WurthElektronik/KiCad-Library/README.md

`KiCad Libraries for Würth Elektronik Products`
=========
## Introduction
Welcome to Würth Elektronik KiCad Library repository. <br>
The libraries are created and maintained by Würth Elektronik EDA Team, for any questions and suggestions please feel free to contact EDA team by email: <libraries@we-online.com>

## Library Component Coverage
* Electromechanical Components <br>
_Assembly, Connectors, REDCUBE Terminals, Switches_

* Optoelectronic Components <br>
_7 Segments Display, IC LEDs, Infrared, Laser, LEDs, Optical Sensors, Optocoupler, Ultraviolet_

* Passive Components <br>
_Capacitors, Crystals & Oscillators, EMC & RFI Components, Inductors, Resistors, Signal & Communications, Transformers_

* Power Modules (MagI3C Series) <br>
_Digital Isolator, Isolated Converter, LED Driver, Step Down Converter_

## More Library Repositories Provided By Würth Elektronik
**PCB Library**: [Cadence](https://github.com/WurthElektronik/Cadence-Library), [Eagle](https://github.com/WurthElektronik/Eagle-Library), [Altium](https://github.com/WurthElektronik/Altium-Library)    <br>
**Simulation Library**: [ADS](https://github.com/WurthElektronik/ADS-Library), [Ansys](https://github.com/WurthElektronik/Ansys-Library), [IBIS](https://github.com/WurthElektronik/IBIS-Library), [LTspice](https://github.com/WurthElektronik/LTspice-Library), [Pspice](https://github.com/WurthElektronik/Pspice-Library), [Qspice](https://github.com/WurthElektronik/Qspice-Library)
