WurthElektronik/KiCad-Library/how_to_contact_us.txt

Please let us know if you have any advice or questions:
libraries@we-online.com
