WurthElektronik/KiCad-Library/(commit log)

2024-10-22 upload and update library
    new upload:
    MLCC capacitor: WCAP-CSGP
    Ferrite: WE-CBF, WE-CBF-HF, WE-MPSB, WE-TMSB
    CM chokes: WE-CMB, WE-CNSW
    update:
    Power Inductor: WE-HCI, WE-LQS, WE-LQSH, WE-MAPI, WE-PD, WE-PMCI, WE-PMI, WE-TI
2025-01-07 upload library
    WCAP-AIG8
    WCAP-AIE8
    WCAP-AIG5
    WCAP-AI3H
    update WP-RATR footprint
2025-01-16 upload library
    Power Modules
2025-04-16 update library
    update all capacitor symbols and update all footprint value to invisible
2025-09-12 upload library
    2025.09.12:
    WE-GDT
    WE-CMBH
    WE-CMBHV
    WE-HCFAT
    WE-STST
    WE-UOST
    WE-SMGS
    WE-LLCR
    WE-BMS
    WE-UKW
    WE-WAFB
    WE-PSPA
    WE-PoEH
    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
2025-10-31 update library
    update WE-TVSP footprint with more visible anode remark
2025-12-04 update library
    Add an excel to display all released series of WE product
    [Git_WE_KiCad_Released_Series_List.xlsx]
2025-12-26 upload library
    Merry Christmas and Happy New Year!
    2025.12.26:
    WL-OCTR
    WE-IBTI
    WE-FLYTI
    WE-OLEFD
    WE-OLLT
    WE-OLEE
    WE-OLRM
    WE-PPTM
    WE-OLPI
    [Git_WE_KiCad_Released_Series_List.xlsx]
2026-01-26 upload and update library
    2026.01.26
    WR-NPC2
    WE-VD
    [Git_WE_KiCad_Released_Series_List.xlsx]
2026-01-29 update library
    2026.01.29:
    WE-GF
    WE-PDA
    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
    [Git_WE_KiCad_Released_Series_List.xlsx]
2026-03-06 upload and update library
    2026.03.06
    upload:
    WE-SFIA
    WS-TASV
    WE-PMFI
    WR-PHD
    WPME-FIMM
    WPME-LDHM
    WPME-VDRM
    WPME-VISM
    WPME-FDSM
    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
    [Git_WE_KiCad_Released_Series_List.xlsx]
2026-03-10 update library
    WCAP-FTY2.kicad_sym 890404123003CS capacitance value change
2026-03-11 update library
    update WE-CMB.kicad_sym
2026-03-20 upload and update library
    2026.03.20
    upload and update library series list:
    WIRL
    WCAP-FTY2
    WS-DITV
    WS-DISV
    WS-RSTV
    WS-ROSV
    WS-TATV
    WS-ROTU
    WS-TATU
    WS-TASU
    WS-DITU
    WS-TATL
    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
    [Git_WE_KiCad_Released_Series_List.xlsx]
2026-04-01 update library
    update symbol value field with exact RLCF value for resistor, inductor, capacitor, crystal;
    update symbol's meta field to remove special unit symbol and replace with normal character;
    update connector pin length from 2.54mm to 3.81mm to align with kicad default connector symbol. If only designer don't update the synbol by click the symbol and update or click "Update symbol from library' under Tool, the schematic will not be affected.
    [Git_WE_KiCad_Released_Series_List.xlsx]
2026-04-03 upload library
    WL-SIMW
    WL-VCSL
    WL-SFCD
    WL-SFSW
    WL-STCW
    WL-SWTC
    WL-SBSW
    WL-SDCB
    WL-SDSB
    WL-SFCC
    WL-SFRW
    WL-STCB
    WL-STRB
    WL-TDRB
    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
    [Git_WE_KiCad_Released_Series_List.xlsx]
2026-04-27 upload library
    2026.04.27
    WE-D-SUB
    WE-TVS
    WR-CIRCM12
    WR-SMA
    WR-WSP
    WR-LECO
    WR-FSH
    WR-MCX
    WR-RPSMA
    WR-SMP
    WR-WST
    WR-SMB
    WR-MMCX
    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
    [Git_WE_KiCad_Released_Series_List.xlsx]
2026-05-07 update and upload library
    2026.05.07
    WR-USB
    WR-CRD
    [Git_WE_KiCad_Released_Series_List.xlsx]
2026-05-22 uoload and update library
    WE-AGDA
    WE-MCRI
    WPME-CDI2C
    [Git_WE_KiCad_Released_Series_List.xlsx]
2026-06-16 upload library
    2026.06.16:
    WR-TBL
    From now this repository is the same with WE homepage status, all library is available.
    [Git_WE_KiCad_Released_Series_List.xlsx]
2026-06-29 upload and update library
    2026.06.29
    WCAP-AWG5
    WCAP-AWG8
    WE-MTCI
    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
    [Git_WE_KiCad_Released_Series_List.xlsx]
2026-07-03 update library
    2026.07.03
    WIRL Radio Module
    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
    [Git_WE_KiCad_Released_Series_List.xlsx]
2026-07-07 update library
    update WE-CNSA
    upload fp-lib-table and sym-lib-table for kicad v10 version to help now import the complete footprint and symbol libraries in one go and keep updated along with the git clone.
    update user manual
    Thanks for the feedback and advice form some users. With your valuable suggestions, now we merge lib tables in our repo. Please continue to let us know if you have any advice. Thanks a lot for your efforts!
    [Git_WE_KiCad_Released_Series_List.xlsx]
2026-07-14 update library
    [Git_WE_KiCad_Released_Series_List.xlsx]
2026-08-05 upload library
    WL-OCHS
    [Git_WE_KiCad_Released_Series_List.xlsx]
2026-08-14 update library
    WE-PD
    WL-SISW
    WE-TIHV
    WE-PMCI
    WL-SWTP
    WPME-FISM
    WE-CSIM
    [Git_WE_KiCad_Released_Series_List.xlsx]
2026-08-18 upload library
    WPME-FIRM
    [Git_WE_KiCad_Released_Series_List.xlsx]
2026-08-20 upload library
    WE-MPSA
    [Git_WE_KiCad_Released_Series_List.xlsx]
2026-08-25 update library
    6297220*0114 Bpad pin order update
2026-08-25 update library
    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
    [Git_WE_KiCad_Released_Series_List.xlsx]
2026-09-07 upload library
    [Git_WE_KiCad_Released_Series_List.xlsx]
2026-09-15 update library
    WL-SMRW
    WE-TI
    [Git_WE_KiCad_Released_Series_List.xlsx]
2026-09-22 update library
    WE-RJ45LAN
    WE-MXGA
    [Git_WE_KiCad_Released_Series_List.xlsx]
2026-10-08 Update Inductor_Wurth_WE-MK.kicad_sym
    WE-MK
